piotrgrobelny/STM32WL-433MHZ-board/Documentation/Project schematic/STM32WL_board_433MHZ.pdf

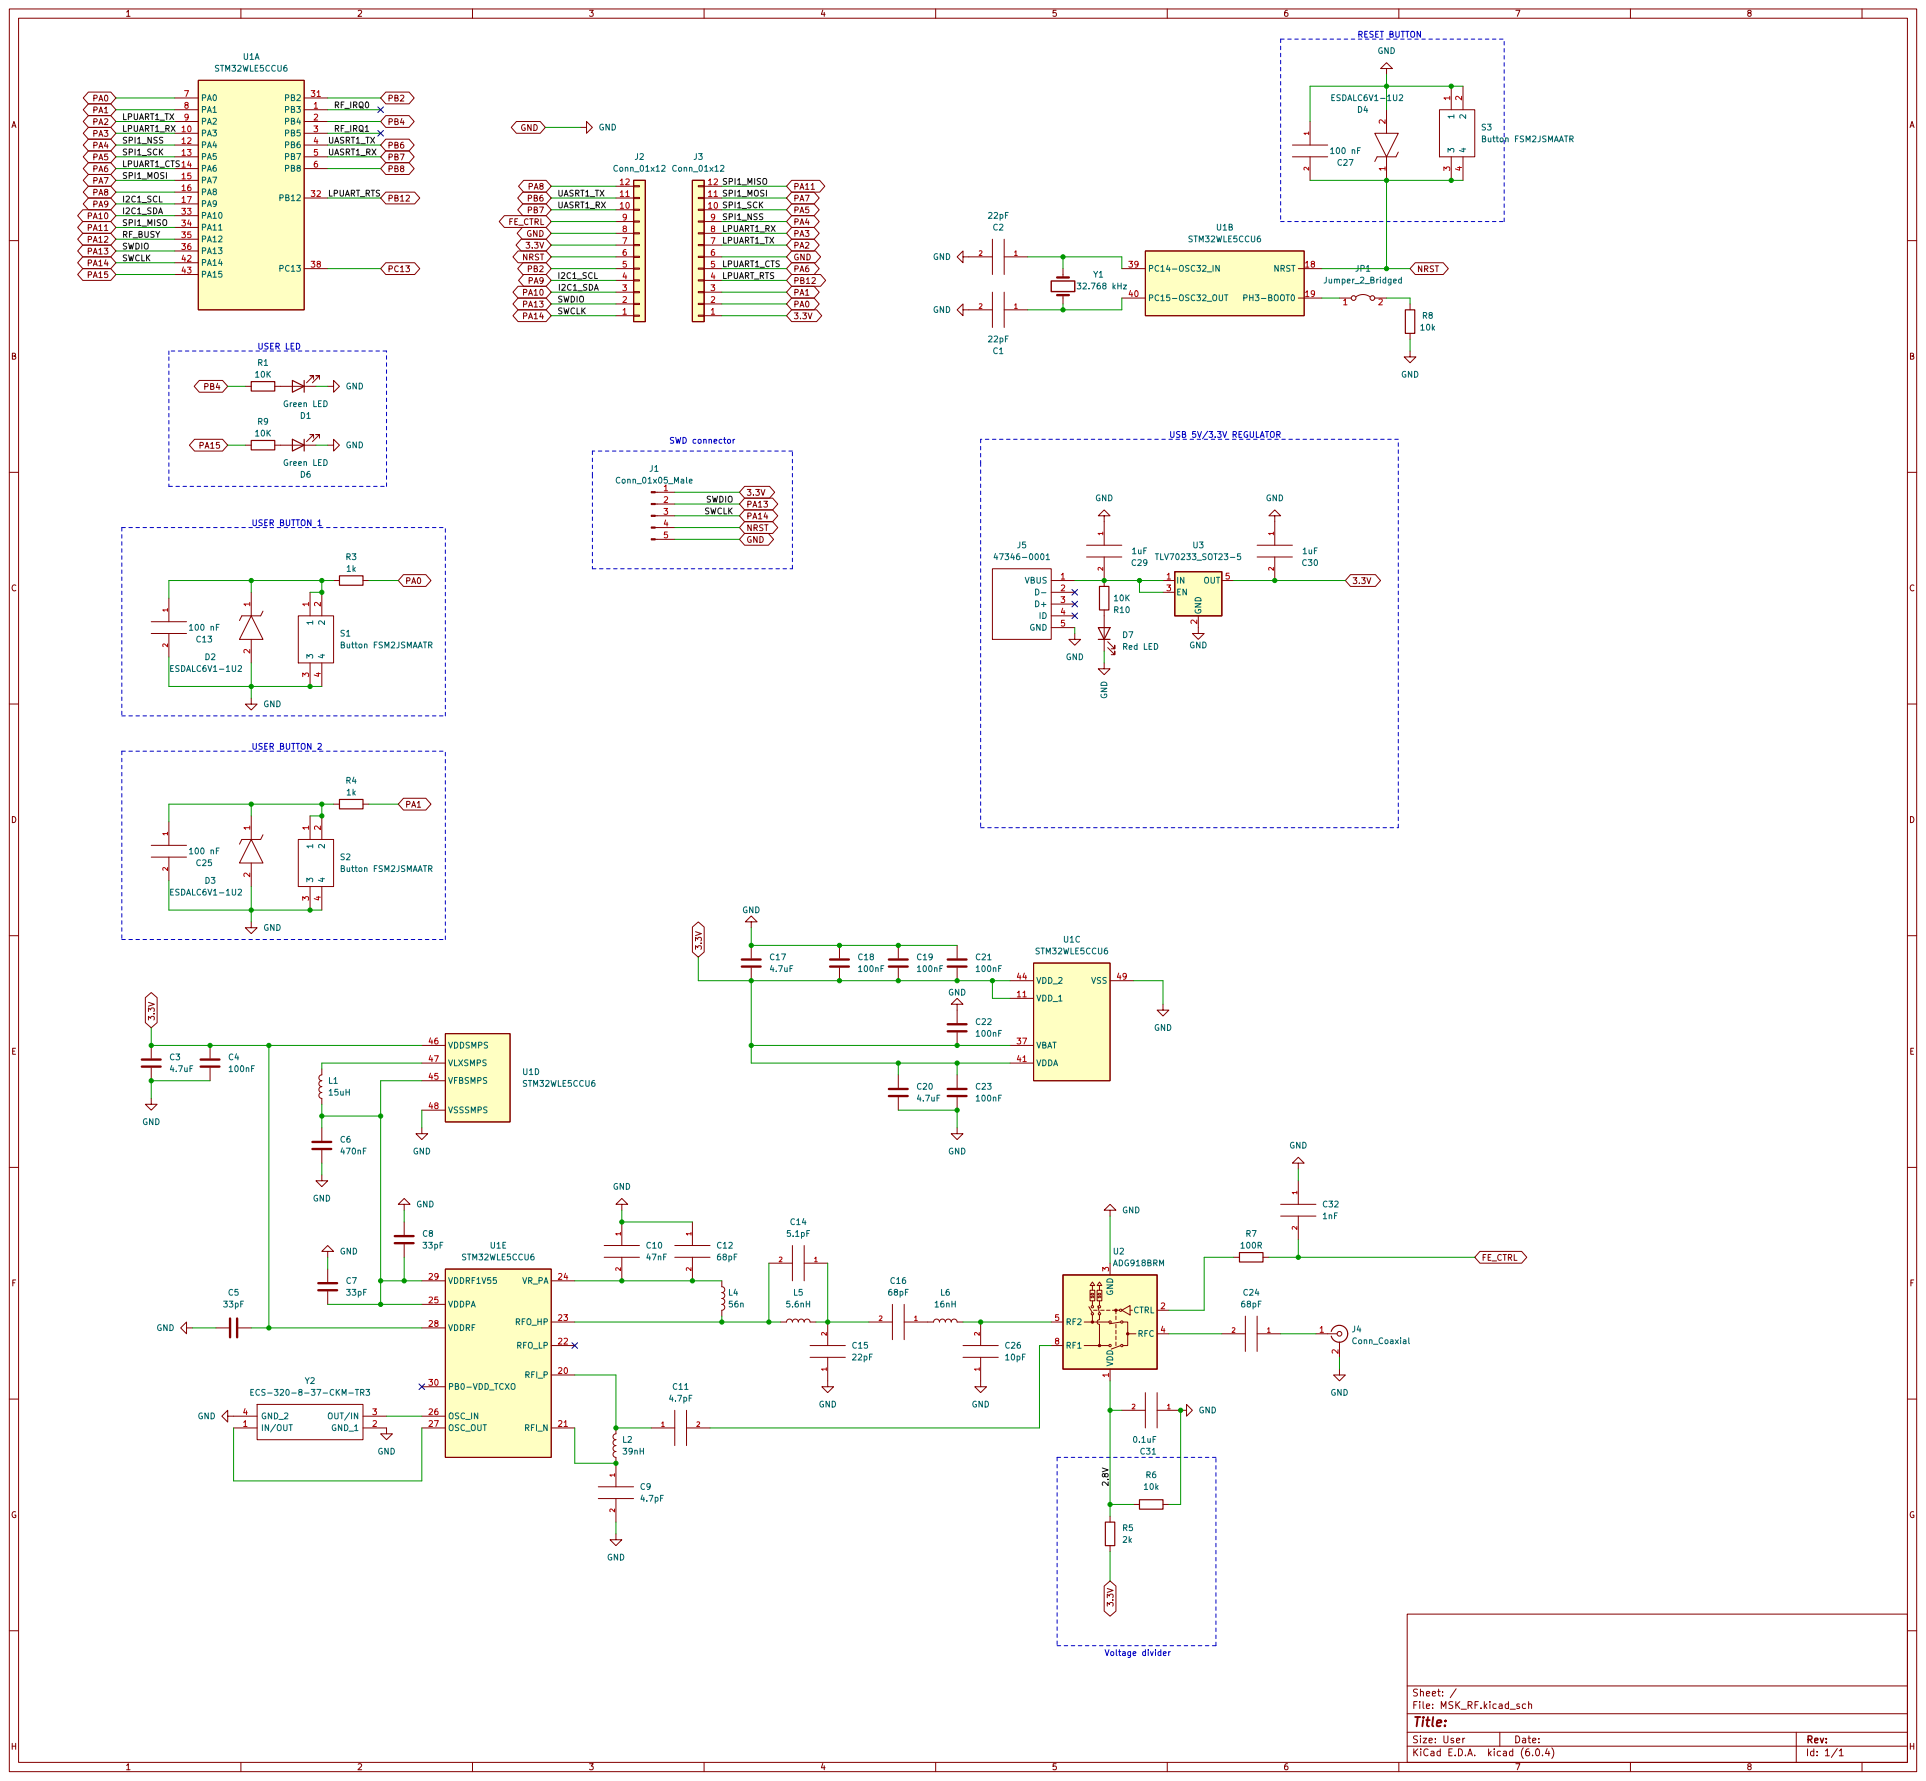
[picture p5: page 1]

SWD connector USER BUTTON 1 USER BUTTON 2
