piotrgrobelny/STM32WL-433MHZ-board/Documentation/STM32WL schematics/en.MB1389-WL55JC-lowband-E02_Schematic.pdf

Title: Project overview

Size:

Reference:
A4 | Sheet: | of

Revision:

Project: NUCLEO-WL5JC

E 02 | MB1389
2020-April-28

Low-band

Date:

Variant:

Table of contents | Legend

General comment such as function title, configuration, ...

Sheet 2: mb1367_Top | Text to be added to silkscreen.

Sheet 1: Project overview (this page)

# NUCLEO-WL5JC

MB1389

Sheet 4: STM32 microcontroller power & user buttons

Sheet 3: STM32 microcontroller I/Os | Warning text.

# OPEN PLATFORM LICENSE AGREEMENT

The Open Platform License Agreement (“Agreement”) is a binding legal contract between you ("You")

and STMicroelectronics International N.V. (“ST”), a company incorporated under the laws of the

Netherlands acting for the purpose of this Agreement through its Swiss branch 39, Chemin du

Champ des Filles, 1228 Plan-les-Ouates, Geneva, Switzerland.

By using the enclosed reference designs, schematics, PC board layouts, and documentation, in hardcopy

or CAD tool file format (collectively, the “Reference Material”), You are agreeing to be bound by

the terms and conditions of this Agreement. Do not use the Reference Material until You have read

and agreed to this Agreement terms and conditions. The use of the Reference Material automatically

implies the acceptance of the Agreement terms and conditions.

The complete Open Platform License Agreement can be found on www.st.com/opla.

U_MB1389_Top
MB1389_Top.SchDoc

Sheet 7: ST-LINK/V3E-SWD Module

Sheet 6: Arduino & Morpho extension connectors

Sheet 8: ST-LINK/V3E-SWD Power Module

Sheet 5: STM32 microcontroller RF

Notes to generate the
board layout.

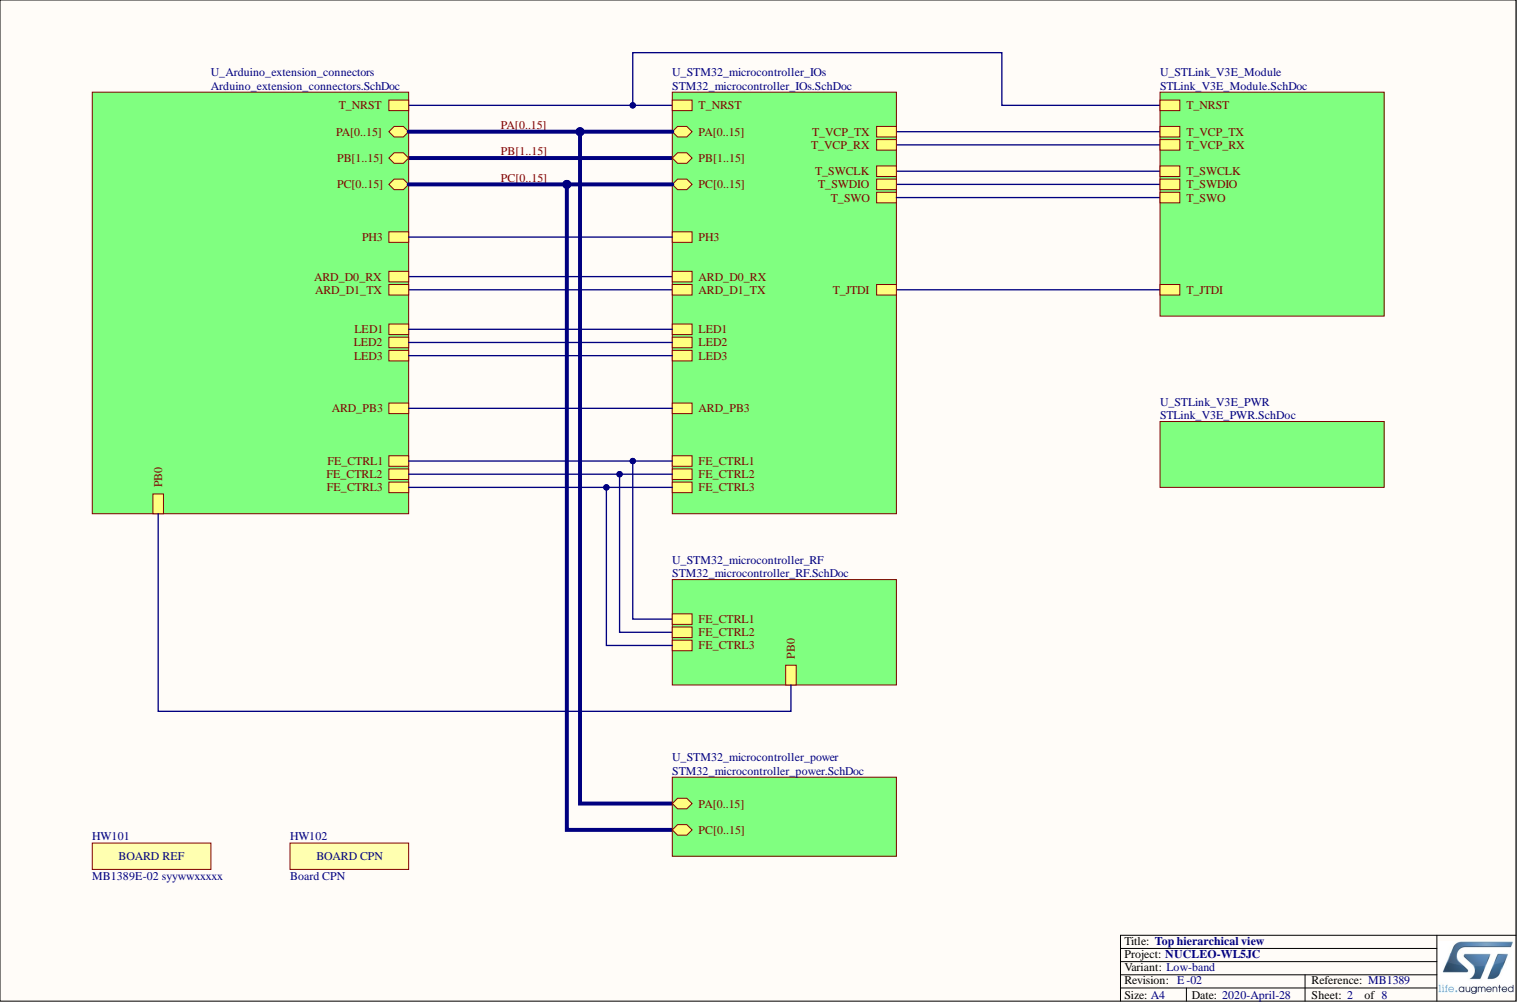
[picture p6: page 2]

Title: Top hierarchical view

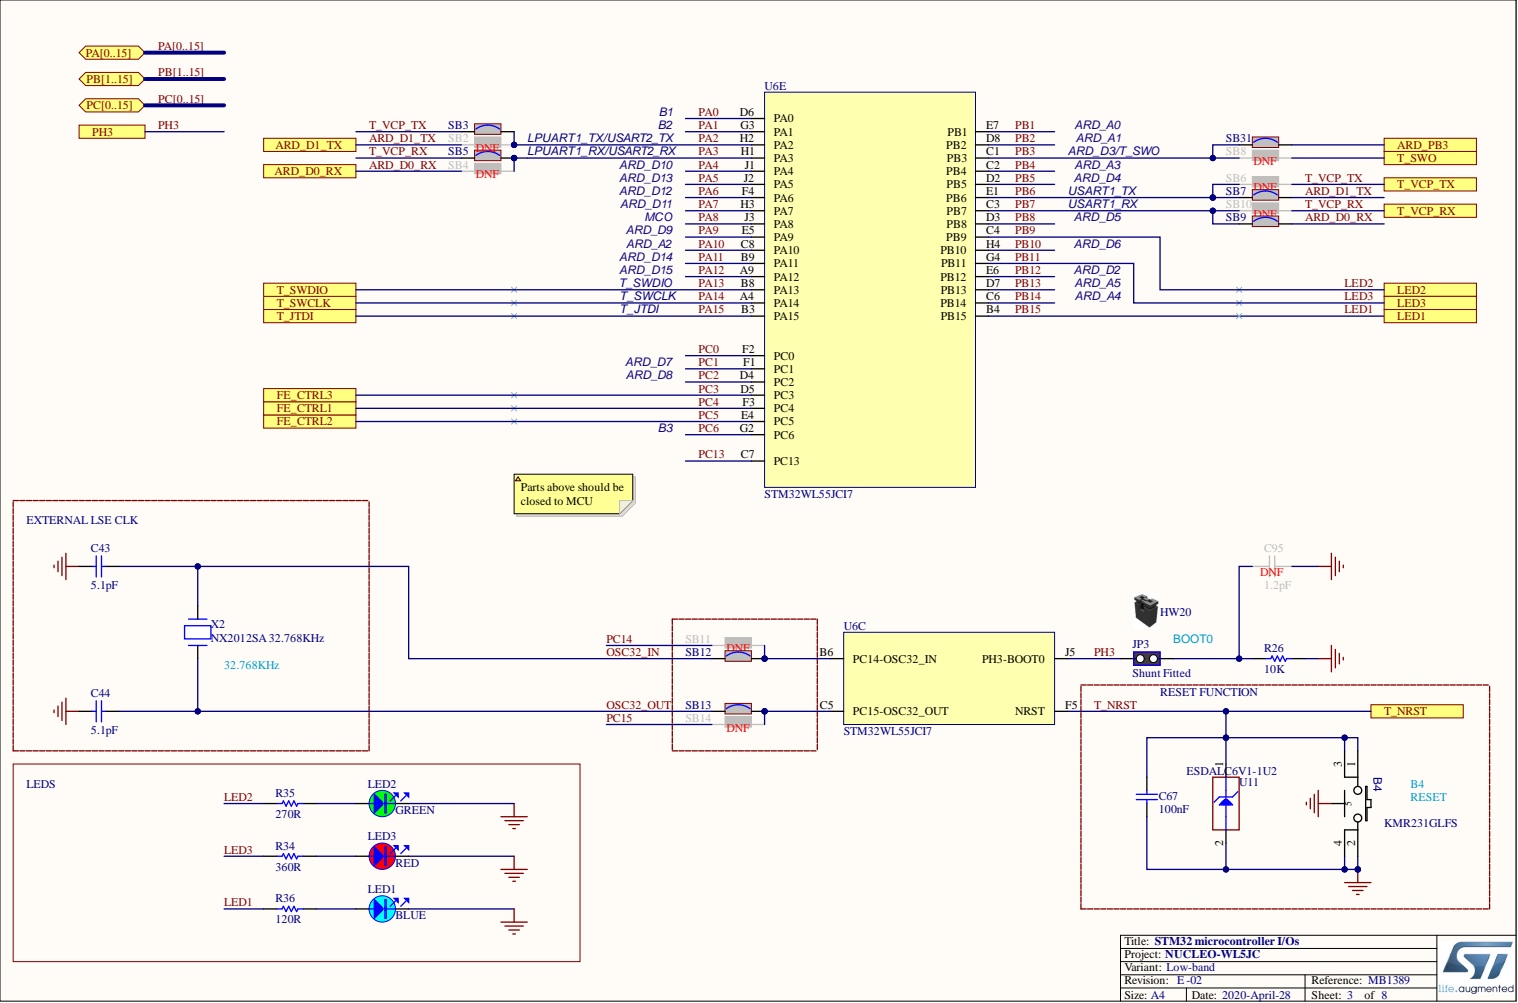
[picture p7: page 3]

T_SWC L K PA 1 4 | | PB1 4 AR D_A 4 L E D 3
T_J TD I PA 1 5 | PB1 5 L E D 1

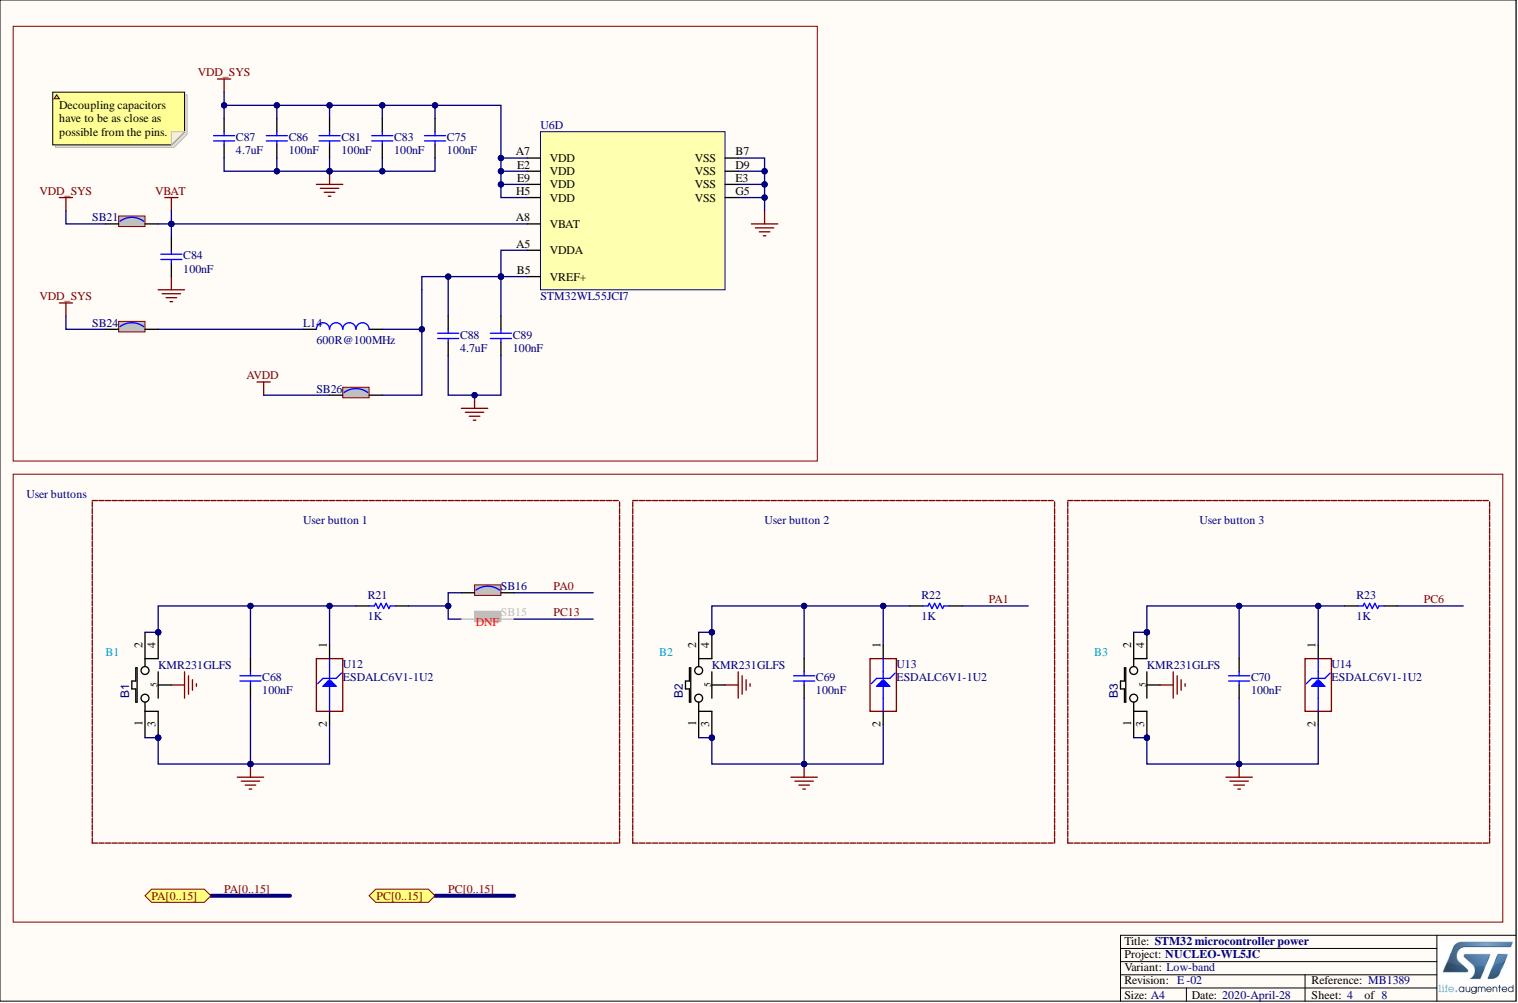
[picture p8: page 4]

Decoupling capacitors
have to be as close as
possible from the pins.

VDDA A5

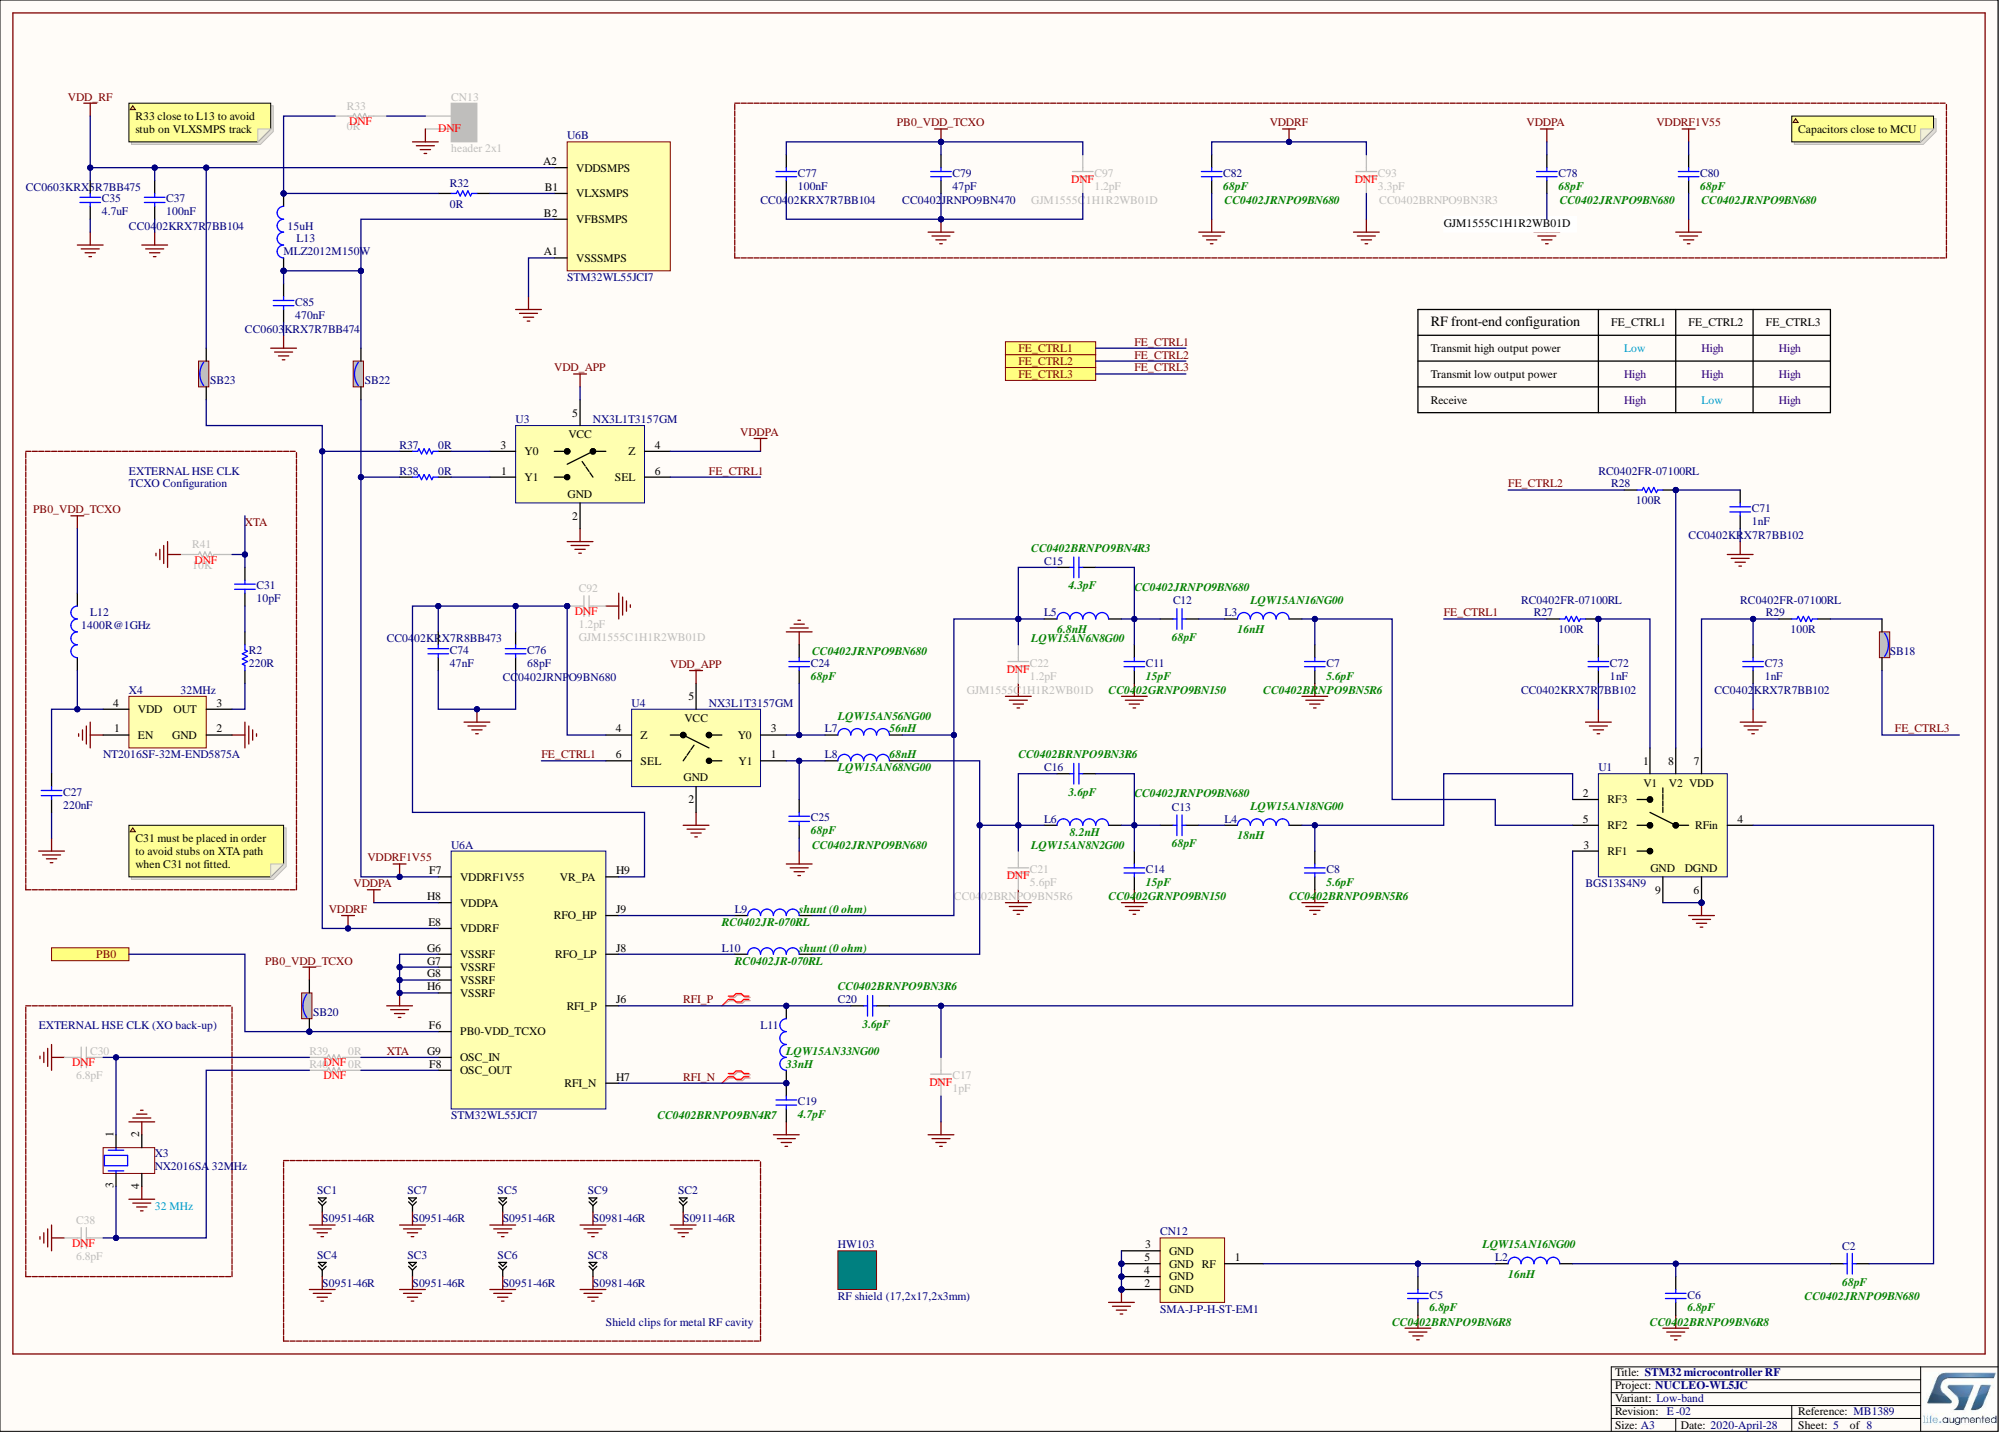
[picture p9: page 5]

R33 close to L13 to avoid
stub on VLXSMPS track

Capacitors close to MCU

RF front-end configuration | FE_CTRL1 | FE_CTRL2 | FE_CTRL3

Transmit high output power | Low | High | High

Transmit low output power

C31 must be placed in order
to avoid stubs on XTA path
when C31 not fitted.

EXTERNAL HSE CLK (XO back-up)

Shield clips for metal RF cavity

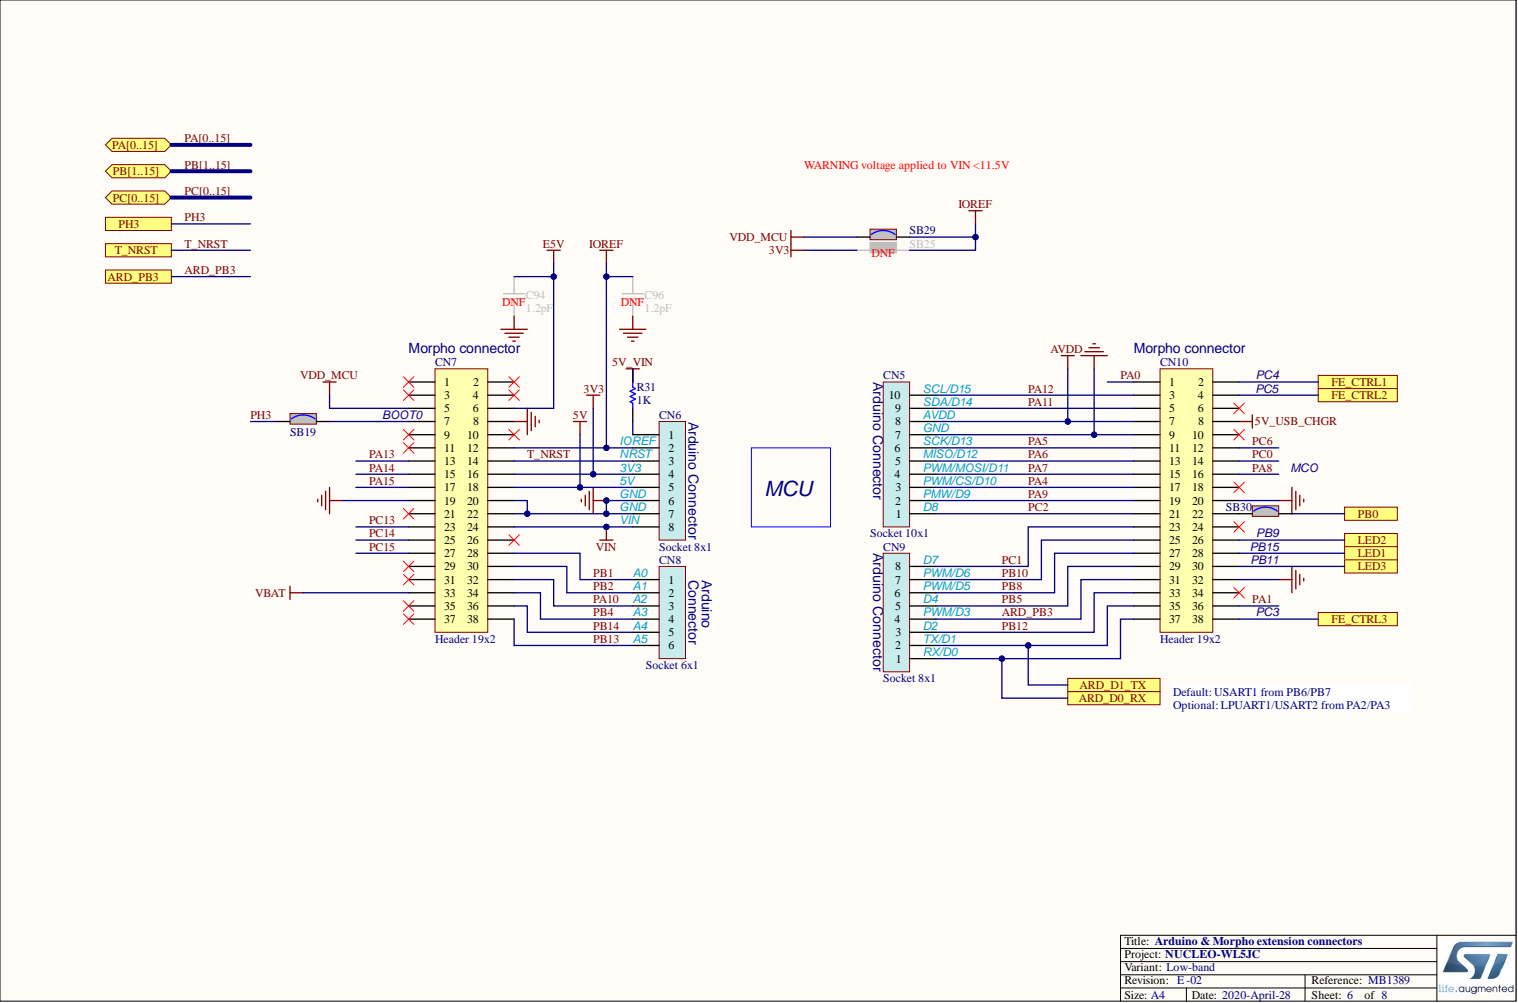
[picture p10: page 6]

WARNING voltage applied to VIN <11.5V

Arduino Connector

Title: Arduino & Morpho extension connectors

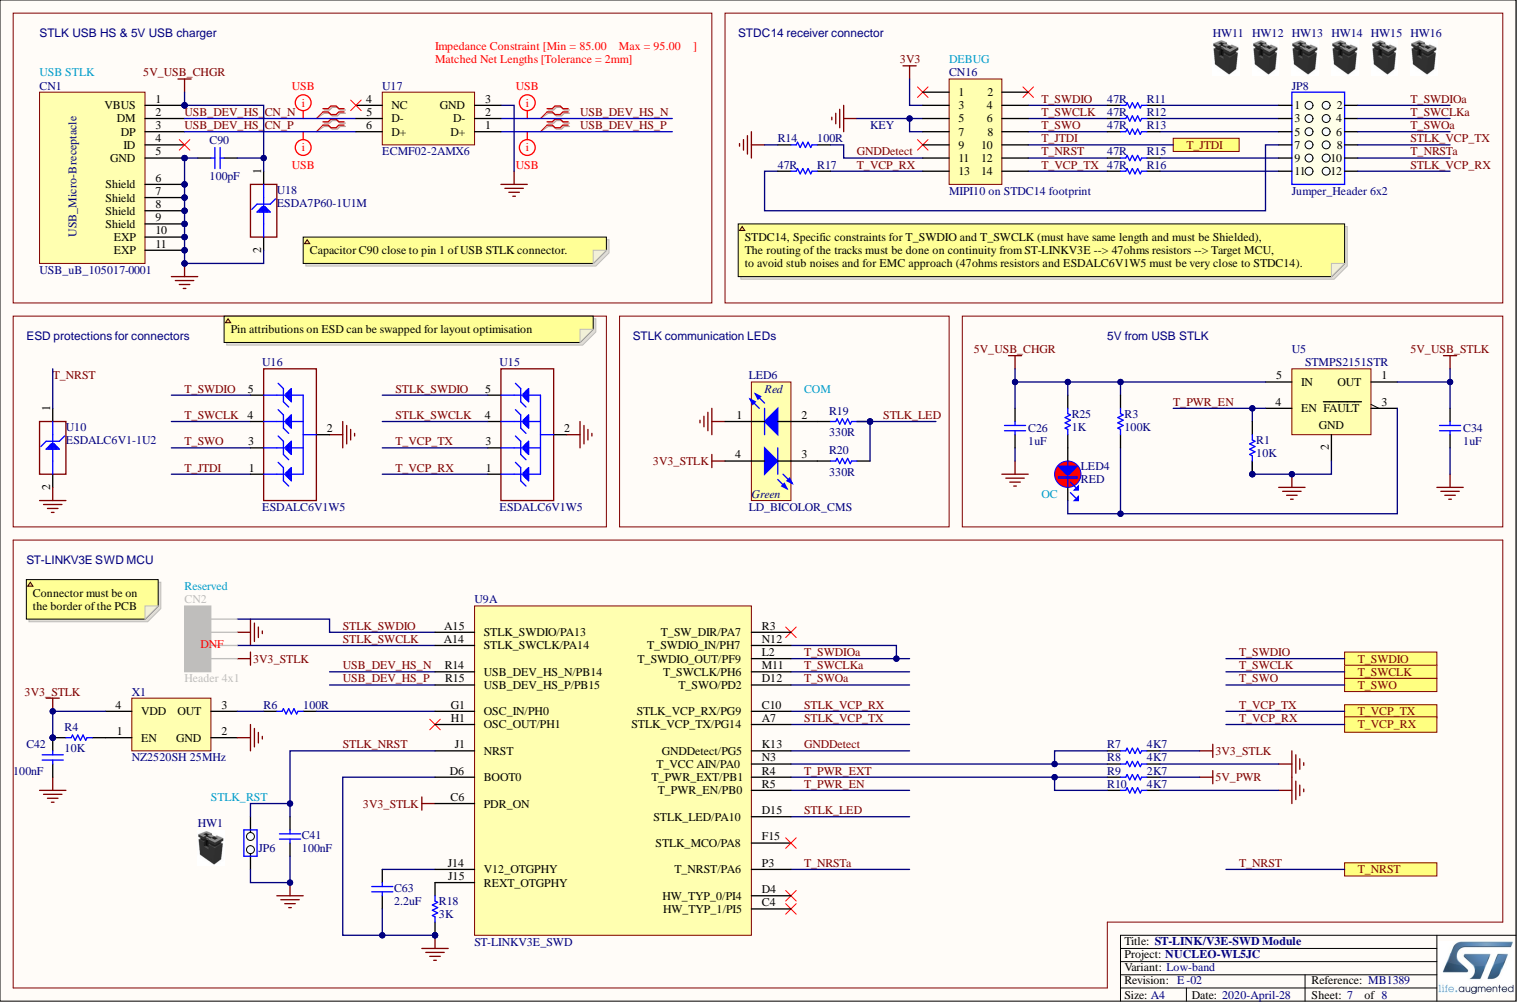
[picture p11: page 7]

Impedance Constraint [Min = 85.00 Max = 95.00 ]
Matched Net Lengths [Tolerance = 2mm]

STDC14, Specific constraints for T_SWDIO and T_SWCLK (must have same length and must be Shielded),
The routing of the tracks must be done on continuity from ST-LINKV3E --> 47ohms resistors --> Target MCU,
to avoid stub noises and for EMC approach (47ohms resistors and ESDALC6V1W5 must be very close to STDC14).

Capacitor C90 close to pin 1 of USB STLK connector.

Pin attributions on ESD can be swapped for layout optimisation

Connector must be on
the border of the PCB

STLK_SWCLK | STLK_SWCLK/PA14 A14
USB_DEV_HS_P | USB_DEV_HS_N/PB14 R14 USB_DEV_HS_P/PB15 R15 OSC_IN/PH0 G1 | | T_SWDIOa

Title: ST-LINK/V3E-SWD Module

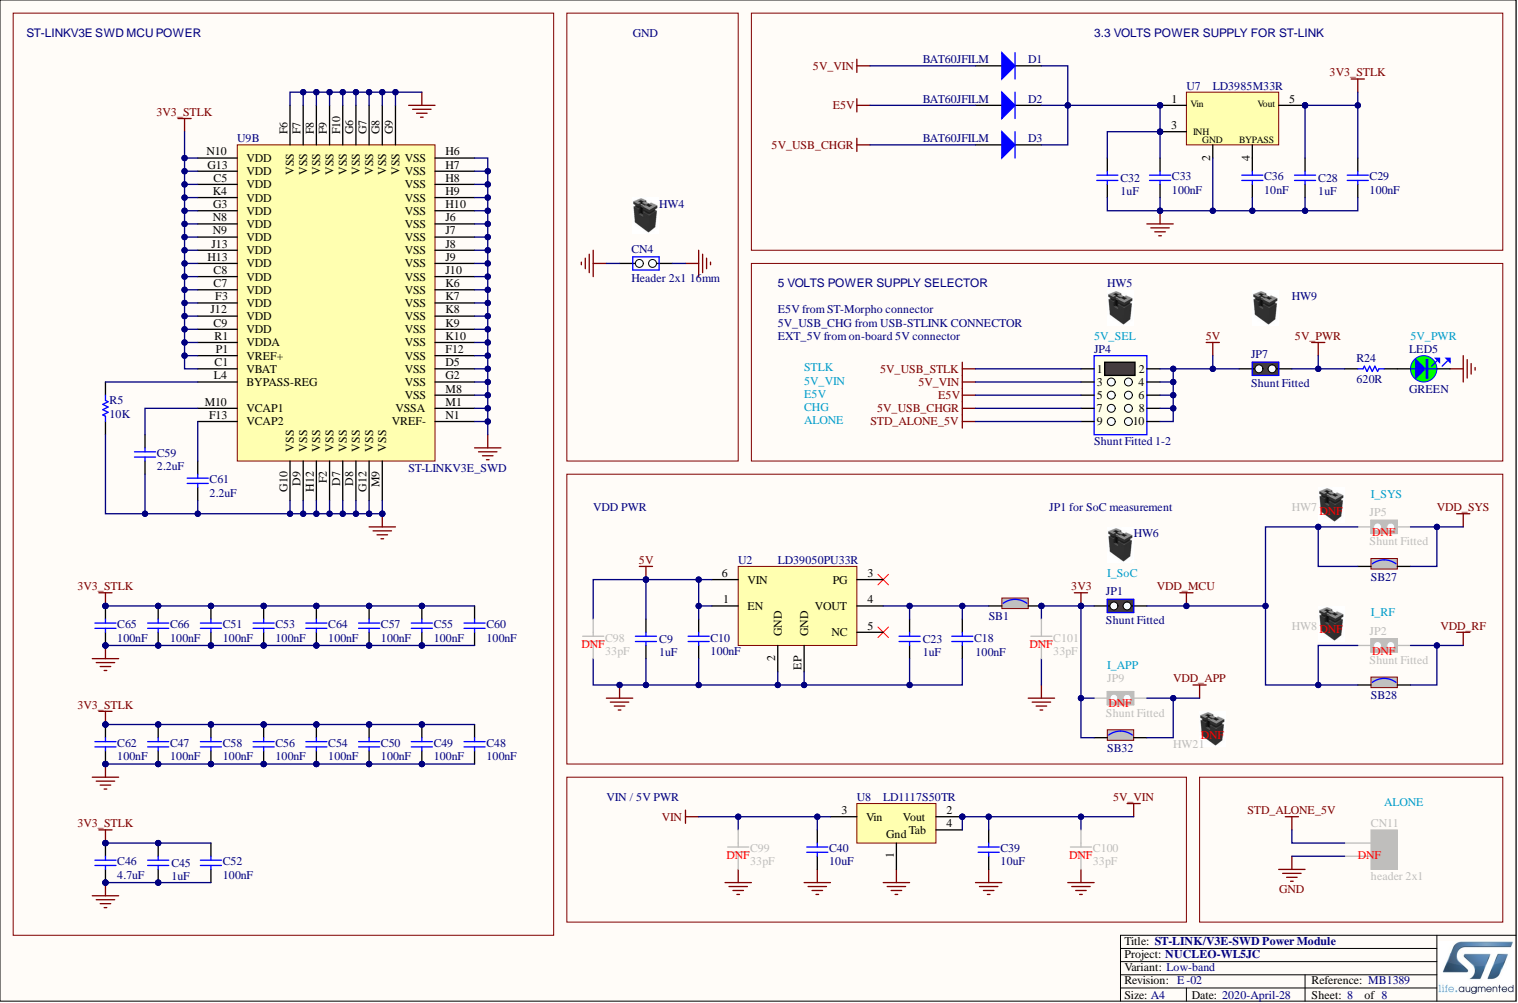
[picture p12: page 8]

ST-LINKV3E SWD MCU POWER

3.3 VOLTS POWER SUPPLY FOR ST-LINK

VSS M9 VSS G12 VSS D8 VSS D7 VSS F2 VSS H12 VSS D9 VSS F6

5 VOLTS POWER SUPPLY SELECTOR

E5V from ST-Morpho connector
5V_USB_CHG from USB-STLINK CONNECTOR
EXT_5V from on-board 5V connector

Title: ST-LINK/V3E-SWD Power Module
