piotrgrobelny/STM32WL-433MHZ-board/Documentation/STM32WL schematics/STM32WL_UFQFPN48_REF_BOARD_Low_Power_Low_Band_433MHz.pdf

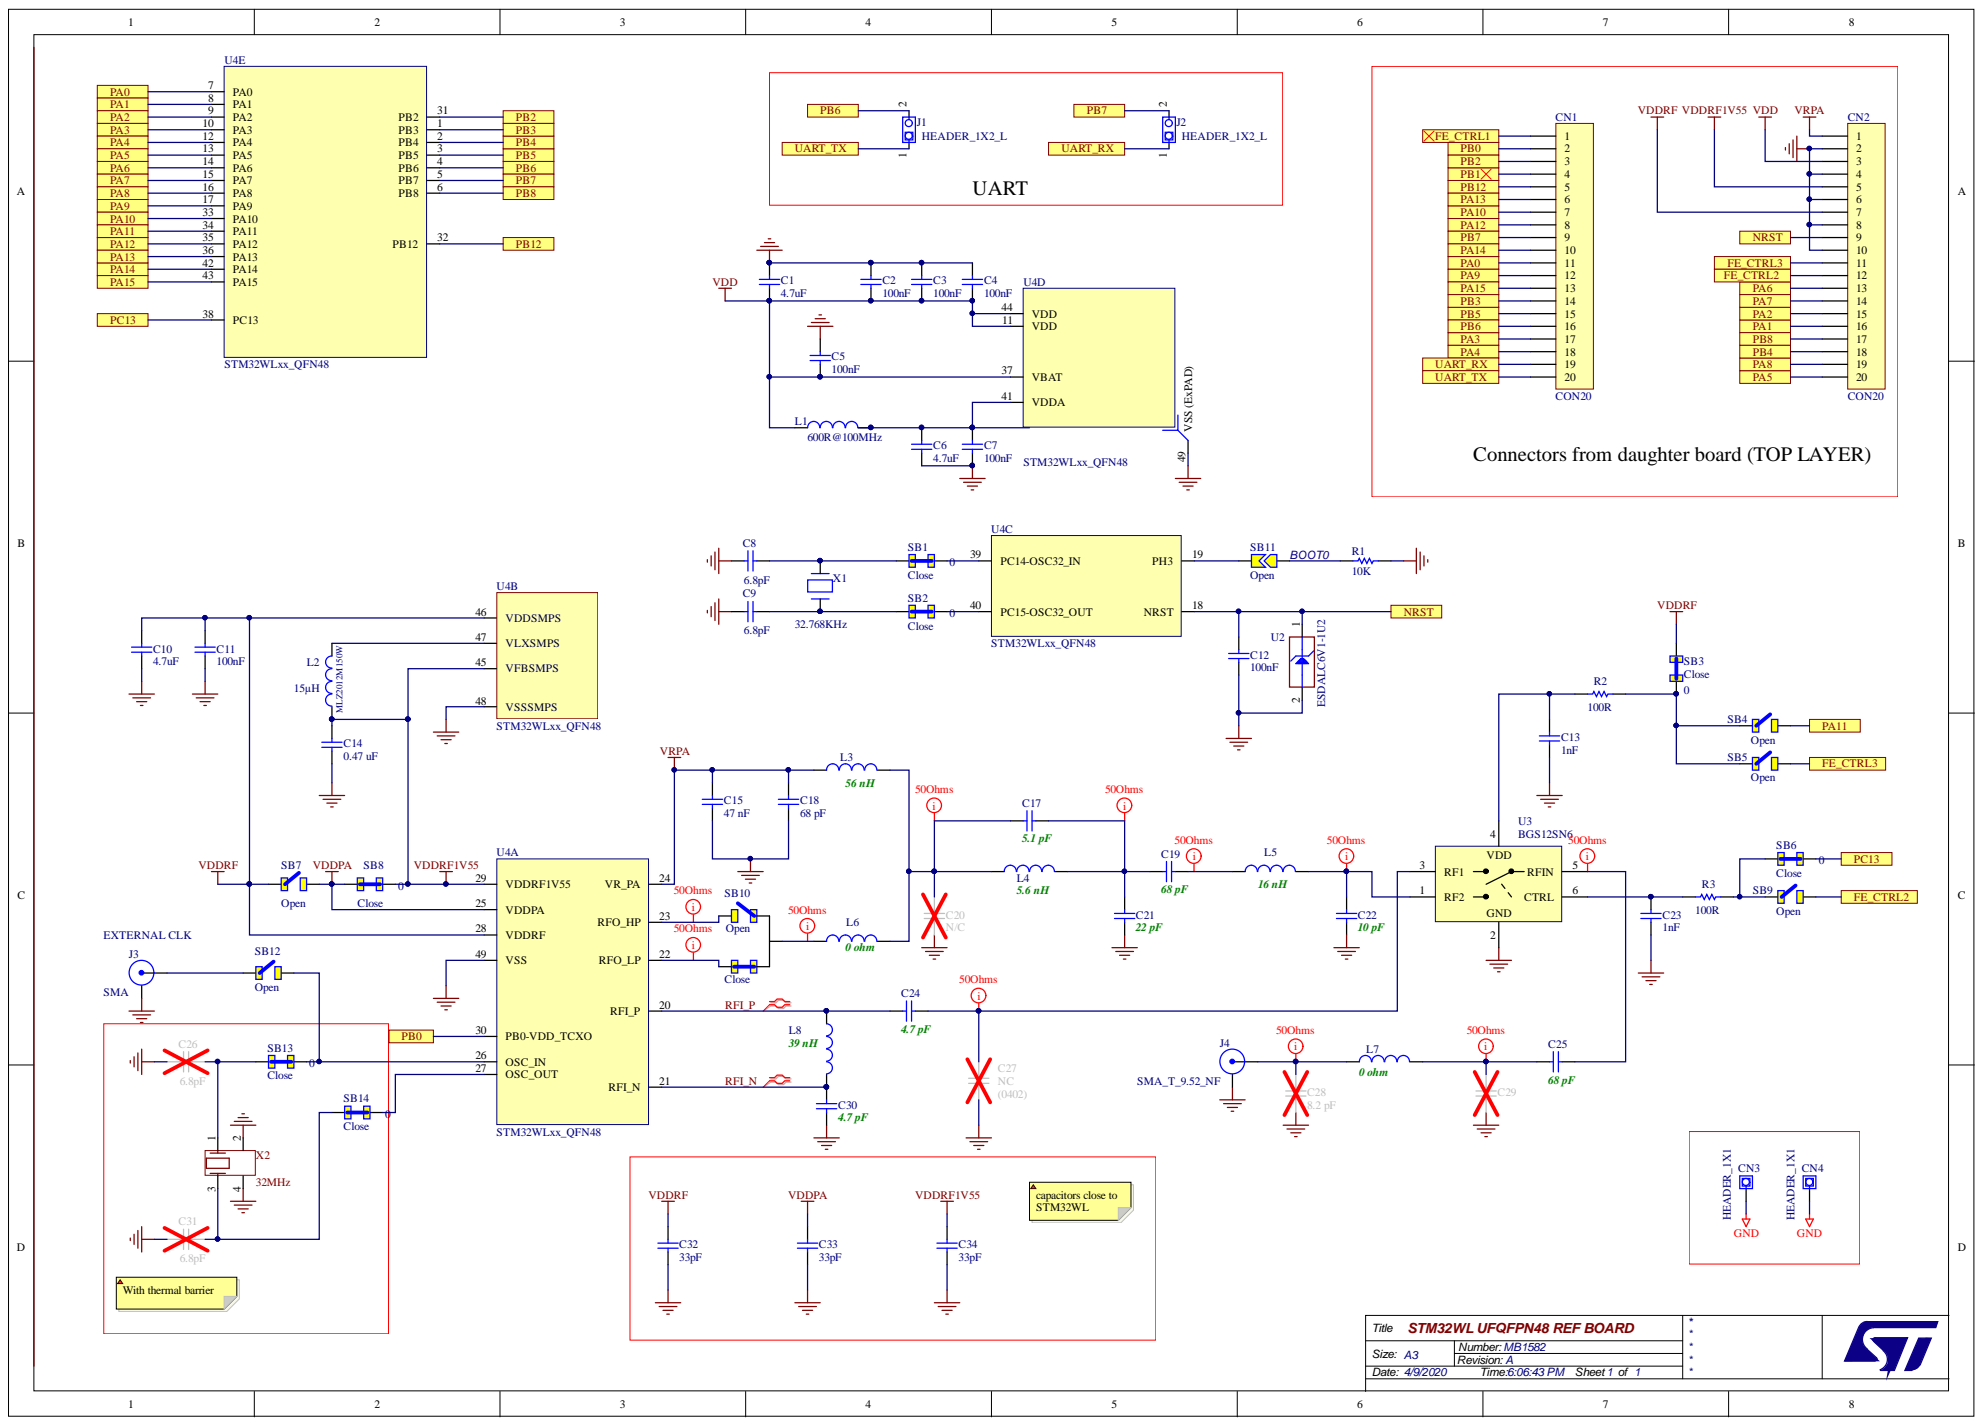
[picture p13: page 1]

Connectors from daughter board (TOP LAYER)

PB0 | OSC_IN 26

Size: A3 | Number: MB1582
