piotrgrobelny/STM32WL-433MHZ-board/KiCad/MSK_RF.kicad_pcb

## KiCad design KiCad/MSK_RF.kicad_pcb (2022-05-19)

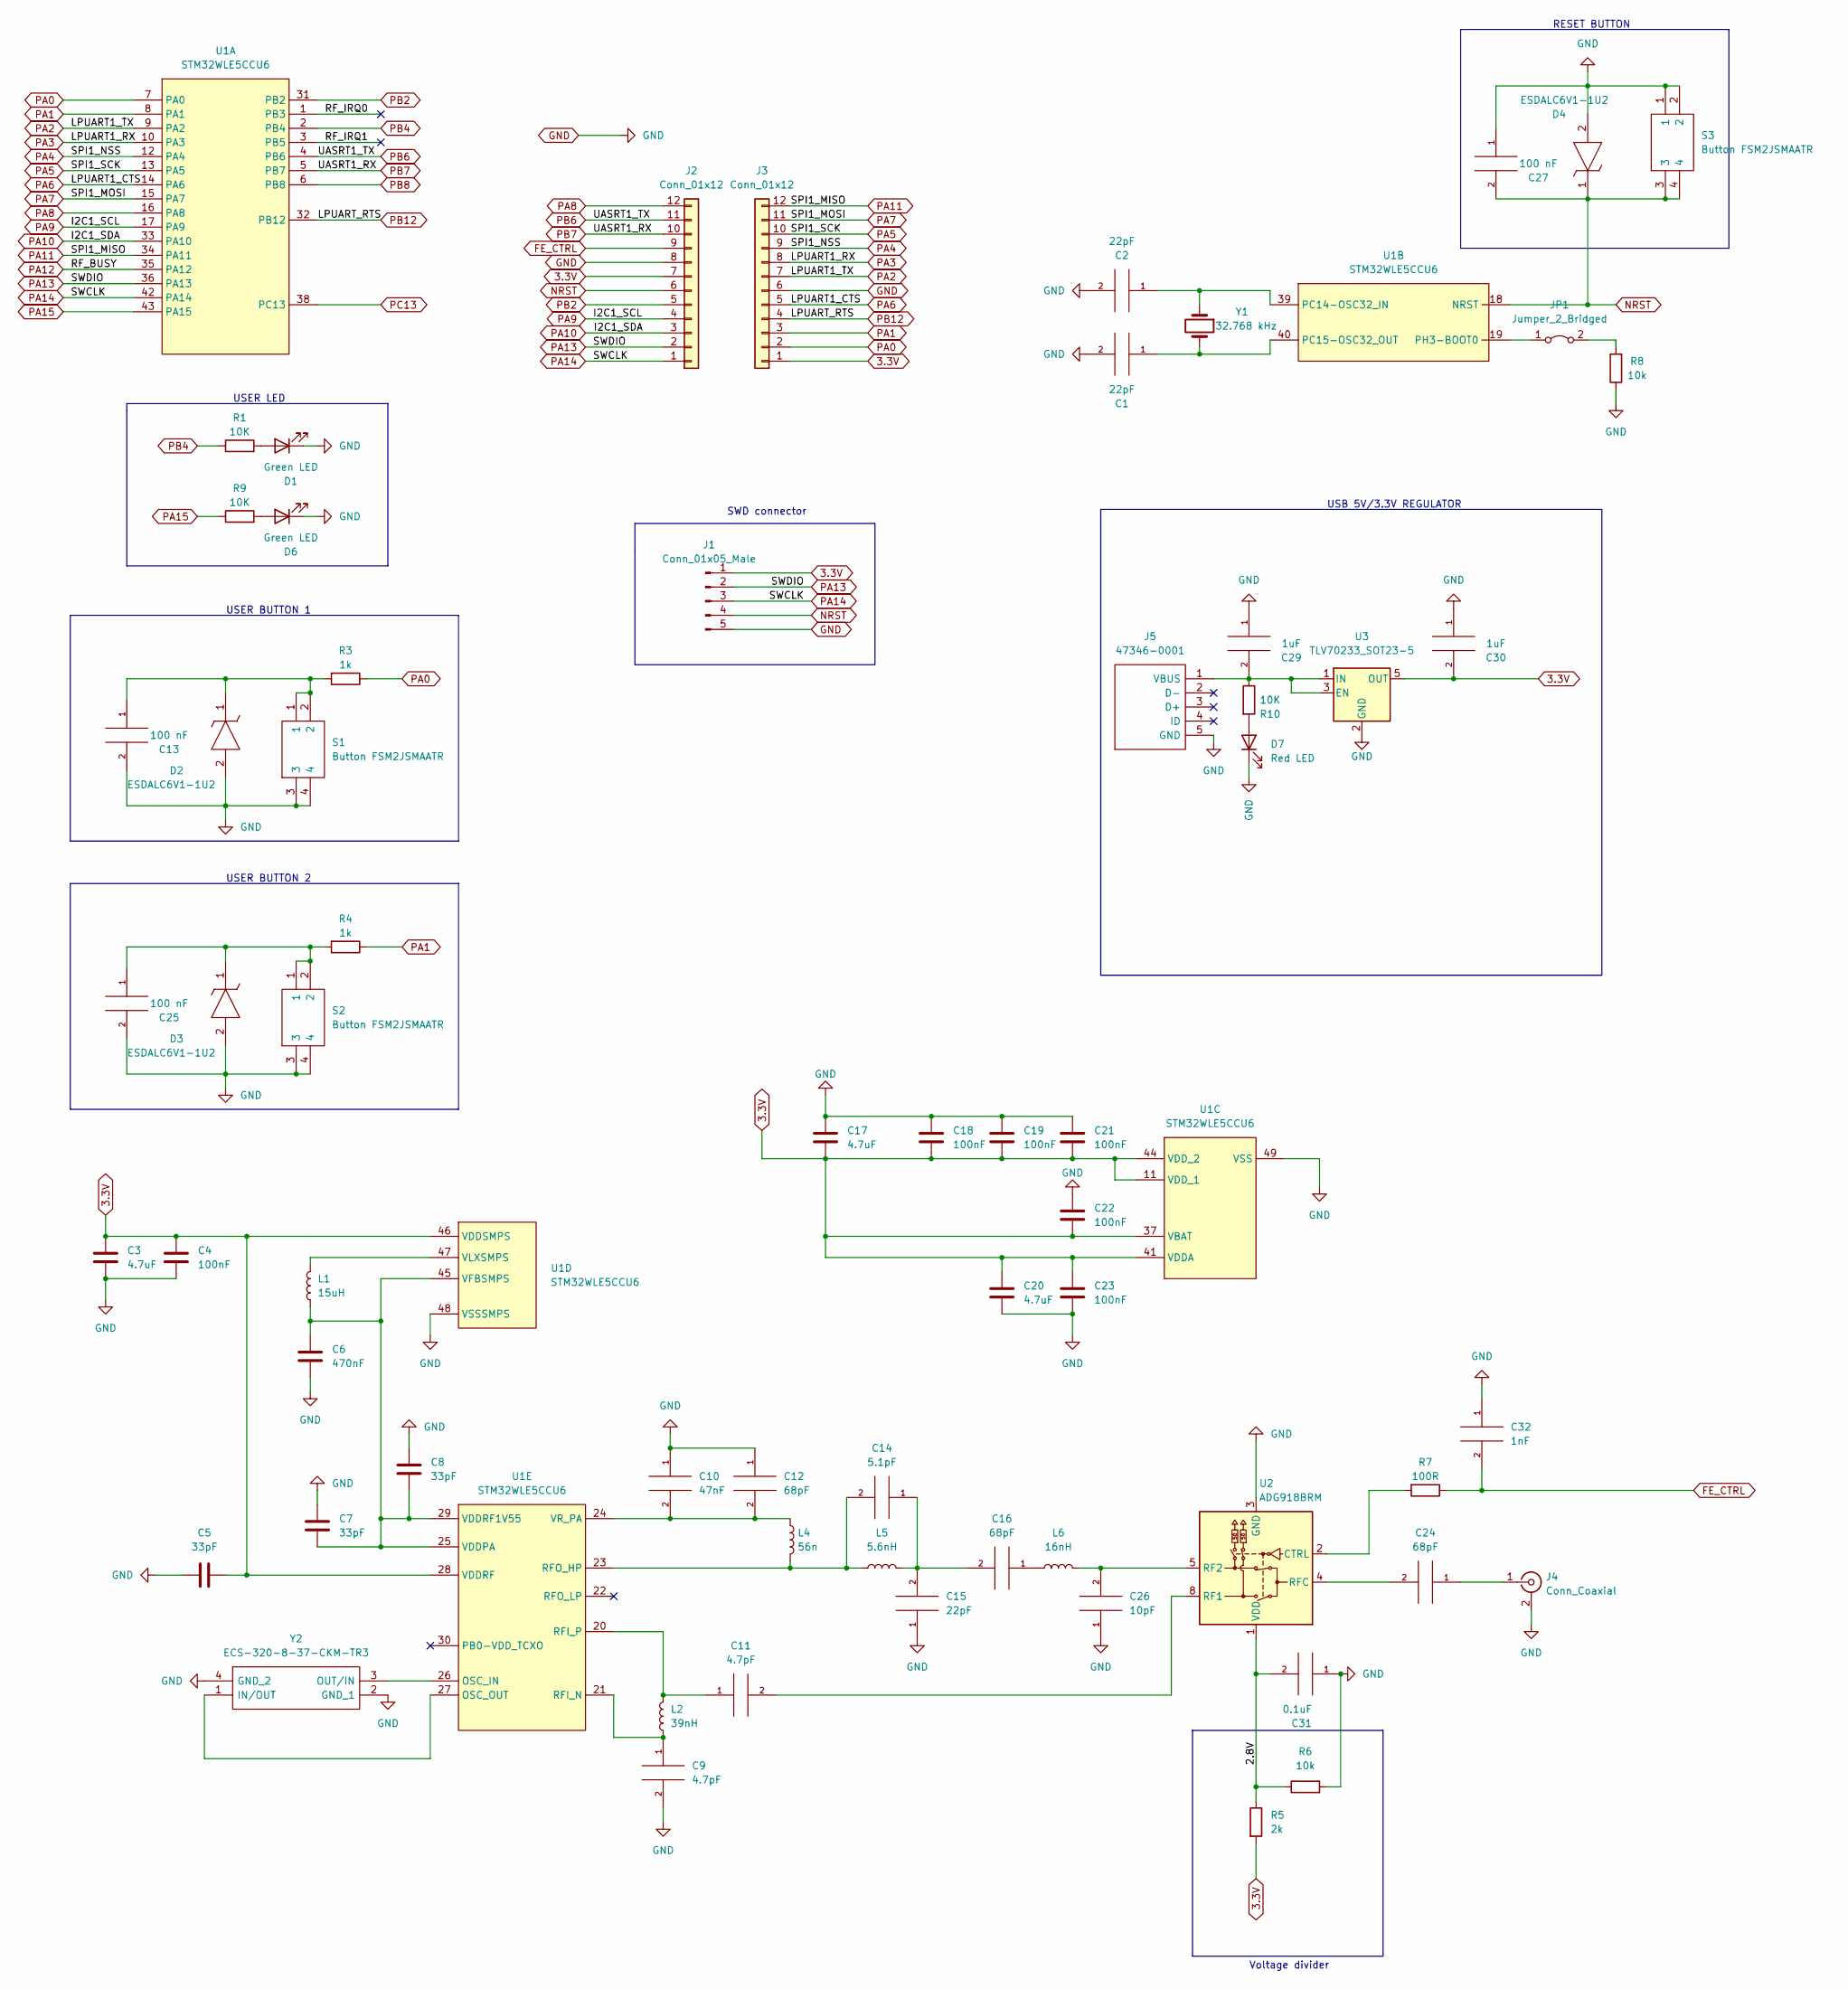
[picture p14: schematic MSK_RF.kicad_sch]

Parts:
C1, C2: 22pF; CP_Elec_3x5.3
C3, C17, C20: 4.7uF; C_0603_1608Metric_Pad1.08x0.95mm_HandSolder
C4, C18, C19, C21, C22, C23: 100nF; C_0603_1608Metric_Pad1.08x0.95mm_HandSolder
C5, C7, C8: 33pF; C_0603_1608Metric_Pad1.08x0.95mm_HandSolder
C6: 470nF; C_0603_1608Metric_Pad1.08x0.95mm_HandSolder
C9, C11: 4.7pF; C_0603_1608Metric_Pad1.08x0.95mm_HandSolder
C10: 47nF; C_0603_1608Metric_Pad1.08x0.95mm_HandSolder
C12, C16, C24: 68pF; C_0603_1608Metric_Pad1.08x0.95mm_HandSolder
C13, C25, C27: 100 nF; C_0603_1608Metric_Pad1.08x0.95mm_HandSolder
C14: 5.1pF; C_0603_1608Metric_Pad1.08x0.95mm_HandSolder
C15: 22pF; C_0603_1608Metric_Pad1.08x0.95mm_HandSolder
C26: 10pF; C_0603_1608Metric_Pad1.08x0.95mm_HandSolder
C29, C30: 1uF; C_0603_1608Metric_Pad1.08x0.95mm_HandSolder
C31: 0.1uF; C_0603_1608Metric_Pad1.08x0.95mm_HandSolder
C32: 1nF; C_0603_1608Metric_Pad1.08x0.95mm_HandSolder
D1, D6: Green LED; LED_0603_1608Metric_Pad1.05x0.95mm_HandSolder
D2, D3, D4: ESDALC6V1-1U2; ESDALC6V11U2; Mouser Part Number 511-ESDALC6V1-1U2
D7: Red LED; LED_0603_1608Metric_Pad1.05x0.95mm_HandSolder
J1: Conn_01x05_Male; PinHeader_1x05_P2.54mm_Vertical
J2, J3: Conn_01x12; PinSocket_1x12_P2.54mm_Vertical
J4: Conn_Coaxial; SMA_Molex_73251-1153_EdgeMount_Horizontal
J5: 47346-0001; Mouser Part Number 538-47346-0001
JP1: Jumper_2_Bridged; PinHeader_1x02_P2.54mm_Vertical
L1: 15uH; L_0603_1608Metric_Pad1.05x0.95mm_HandSolder
L2: 39nH; L_0603_1608Metric_Pad1.05x0.95mm_HandSolder
L4: 56n; L_0603_1608Metric_Pad1.05x0.95mm_HandSolder
L5: 5.6nH; L_0603_1608Metric_Pad1.05x0.95mm_HandSolder
L6: 16nH; L_0603_1608Metric_Pad1.05x0.95mm_HandSolder
R1, R9, R10: 10K; R_0603_1608Metric_Pad0.98x0.95mm_HandSolder
R3, R4: 1k; R_0603_1608Metric_Pad0.98x0.95mm_HandSolder
R5: 2k; R_0603_1608Metric_Pad0.98x0.95mm_HandSolder
R6, R8: 10k; R_0603_1608Metric_Pad0.98x0.95mm_HandSolder
R7: 100R; R_0603_1608Metric_Pad0.98x0.95mm_HandSolder
S1, S2, S3: Button FSM2JSMAATR; FSM2J_1; Mouser Part Number 506-FSM2JSMAATR
U1: STM32WLE5CCU6; QFN50P700X700X60-49N-D
U2: ADG918BRM; MSOP-8_3x3mm_P0.65mm
U3: TLV70233_SOT23-5; SOT-23-5
Y1: 32.768 kHz; ECX-31B
Y2: ECS-320-8-37-CKM-TR3; ECS320837CKMTR3; Mouser Part Number 520-ECS-320837CKMTR3

Connections:
3.3V: C3.1, C4.1, C5.1, C17.2, C18.2, C19.2, C20.1, C21.2, C22.2, C23.1, C30.2, J1.1, J2.7, J3.1, R5.2, U1.11 (VDD_1), U1.28 (VDDRF), U1.37 (VBAT), U1.41 (VDDA), U1.44 (VDD_2), U1.46 (VDDSMPS), U3.5 (OUT)
/2.8V: C31.2, R5.1, R6.1, U2.1 (VDD)
/RF_IRQ0: U1.1 (PB3)
/RF_IRQ1: U1.3 (PB5)
FE_CTRL: C32.2, J2.9, R7.1
GND: C1.2, C2.2, C3.2, C4.2, C5.2, C6.2, C7.1, C8.1, C9.2, C10.1, C12.1, C13.2, C15.1, C17.1, C18.1, C19.1, C20.2, C21.1, C22.1, C23.2, C25.2, C26.1, C27.1, C29.1, C30.1, C31.1, C32.1, D1.1 (K), D2.2, D3.2, D4.2, D6.1 (K), D7.1 (K), J1.5, J2.8, J3.6, J4.2 (Ext), J5.5 (GND), R6.2, R8.1, S1.3, S1.4, S2.3, S2.4, S3.1, S3.2, U1.48 (VSSSMPS), U1.49 (VSS), U2.3 (GND), U2.6 (GND), U2.7 (GND), U3.2 (GND), Y2.2 (GND_1), Y2.4 (GND_2)
NRST: C27.2, D4.1, J1.4, J2.6, S3.3, S3.4, U1.18 (NRST)
unnamed: C1.1, U1.40 (PC15-OSC32_OUT), Y1.2
unnamed: C2.1, U1.39 (PC14-OSC32_IN), Y1.1
unnamed: C6.1, C7.2, C8.2, L1.1, U1.25 (VDDPA), U1.29 (VDDRF1V55), U1.45 (VFBSMPS)
unnamed: C9.1, L2.1, U1.21 (RFI_N)
unnamed: C10.2, C12.2, L4.1, U1.24 (VR_PA)
unnamed: C11.1, L2.2, U1.20 (RFI_P)
unnamed: C11.2, U2.8 (RF1)
unnamed: C13.1, D2.1, R3.2, S1.1, S1.2
unnamed: C14.1, C15.2, C16.2, L5.2
unnamed: C14.2, L4.2, L5.1, U1.23 (RFO_HP)
unnamed: C16.1, L6.1
unnamed: C24.1, J4.1 (In)
unnamed: C24.2, U2.4 (RFC)
unnamed: C25.1, D3.1, R4.2, S2.1, S2.2
unnamed: C26.2, L6.2, U2.5 (RF2)
unnamed: C29.2, J5.1 (VBUS), R10.1, U3.1 (IN), U3.3 (EN)
unnamed: D1.2 (A), R1.2
unnamed: D6.2 (A), R9.2
unnamed: D7.2 (A), R10.2
unnamed: JP1.1 (A), U1.19 (PH3-BOOT0)
unnamed: JP1.2 (B), R8.2
unnamed: L1.2, U1.47 (VLXSMPS)
unnamed: R7.2, U2.2 (CTRL)
unnamed: U1.26 (OSC_IN), Y2.3 (OUT/IN)
unnamed: U1.27 (OSC_OUT), Y2.1 (IN/OUT)
PA0: J3.2, R3.1, U1.7 (PA0)
PA1: J3.3, R4.1, U1.8 (PA1)
PA2: J3.7, U1.9 (PA2)
PA3: J3.8, U1.10 (PA3)
PA4: J3.9, U1.12 (PA4)
PA5: J3.10, U1.13 (PA5)
PA6: J3.5, U1.14 (PA6)
PA7: J3.11, U1.15 (PA7)
PA8: J2.12, U1.16 (PA8)
PA9: J2.4, U1.17 (PA9)
PA10: J2.3, U1.33 (PA10)
PA11: J3.12, U1.34 (PA11)
PA12: U1.35 (PA12)
PA13: J1.2, J2.2, U1.36 (PA13)
PA14: J1.3, J2.1, U1.42 (PA14)
PA15: R9.1, U1.43 (PA15)
PB2: J2.5, U1.31 (PB2)
PB4: R1.1, U1.2 (PB4)
PB6: J2.11, U1.4 (PB6)
PB7: J2.10, U1.5 (PB7)
PB8: U1.6 (PB8)
PB12: J3.4, U1.32 (PB12)
PC13: U1.38 (PC13)

Notes on the sheet:
SWD connector
USER BUTTON 2
RESET BUTTON
USER LED
USB 5V/3.3V REGULATOR
USER BUTTON 1
Voltage divider

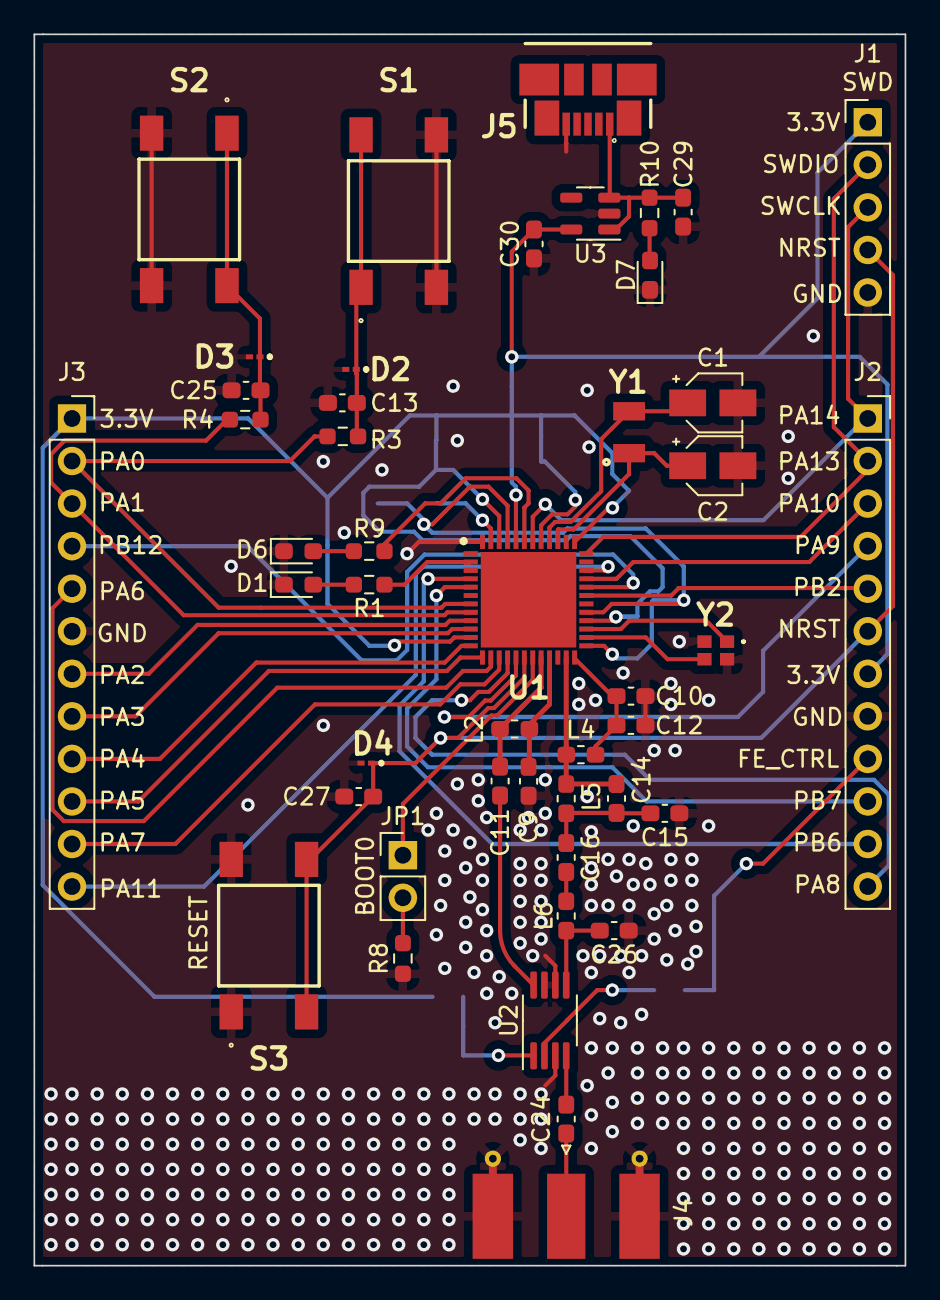
[picture p15: board MSK_RF.kicad_pcb from above]

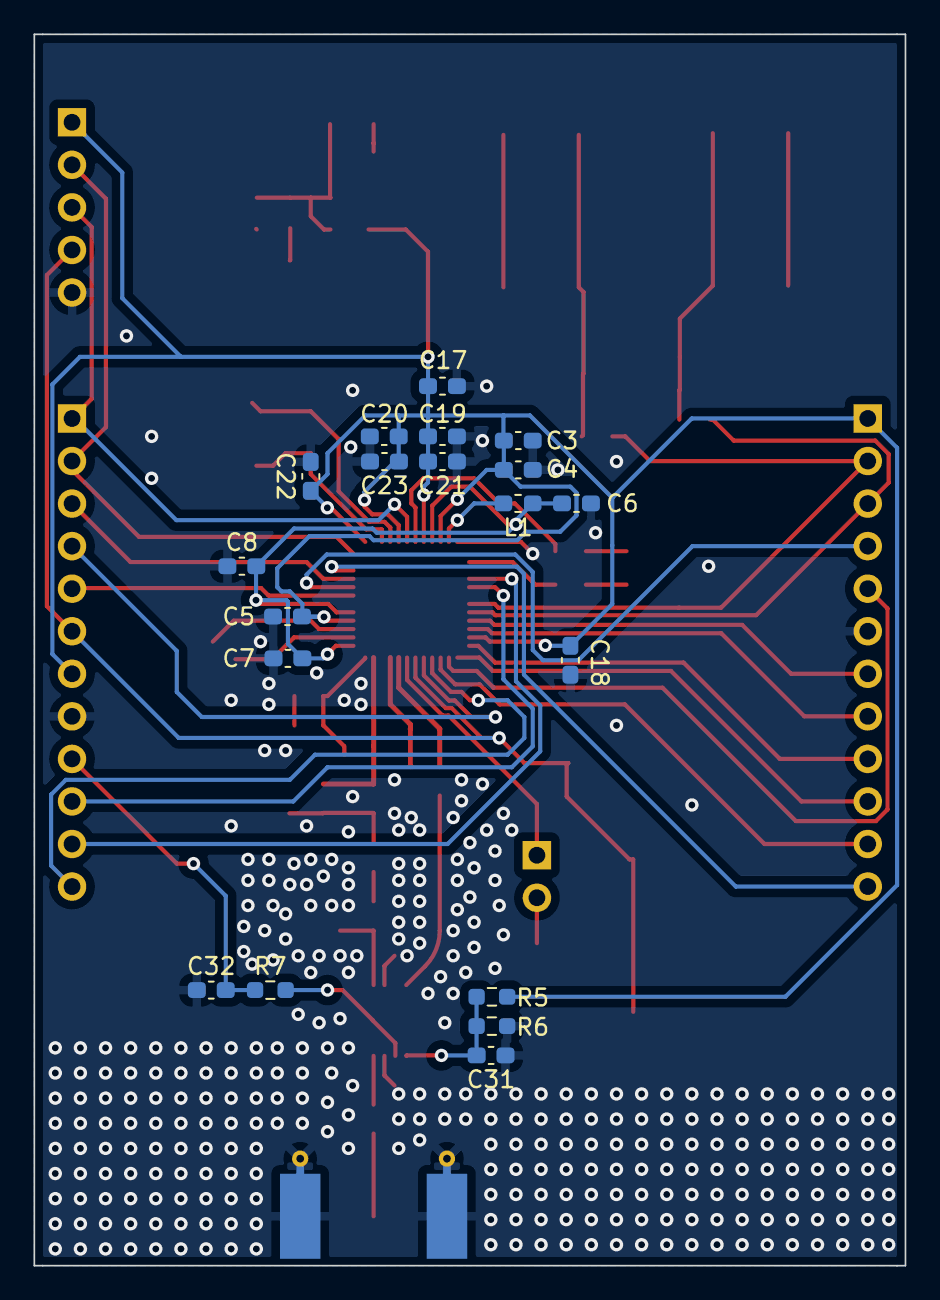
[picture p16: board MSK_RF.kicad_pcb from below]

Board: 2 copper layers, 52.0 x 73.5 mm, 65 parts (19 on the bottom side), 50 nets.
