piotrgrobelny/STM32WL-433MHZ-board/(commit log)

2022-04-15 Documentation and kicad schematics
    [MSK_RF.kicad_pcb, MSK_RF.kicad_sch]
2022-04-15 Second button
    [MSK_RF.kicad_sch]
2022-04-16 added connectors footprint
    [MSK_RF.kicad_sch]
2022-04-16 finished schematic with footprint
    [MSK_RF.csv, MSK_RF.kicad_pcb]
2022-04-19 Added i2c header
    [MSK_RF.kicad_sch]
2022-04-21 pcb update
    [MSK_RF.kicad_pcb, MSK_RF.kicad_sch]
2022-04-21 almost finished pcb
    [MSK_RF.kicad_pcb, MSK_RF.kicad_sch]
2022-04-25 finished pcb
    [MSK_RF.kicad_pcb, MSK_RF.kicad_sch]
2022-04-25 added pin description
    [MSK_RF.kicad_pcb]
2022-04-25 diode description
    [MSK_RF.kicad_pcb]
2022-04-25 drc inspection solved
    [MSK_RF.kicad_pcb]
2022-04-26 gerber files
    [MSK_RF-B_Silkscreen.gbr, MSK_RF-Dolna pasty.gbr, MSK_RF-Dolna sodermaski.gbr, MSK_RF-Dolna sygnałowa.gbr, MSK_RF-F_Silkscreen.gbr, MSK_RF-Górna pasty.gbr, MSK_RF-Górna soldermaski.gbr, MSK_RF-Górna sygnałowa.gbr]
2022-04-26 pin description
    [MSK_RF.kicad_pcb]
2022-04-28 vias update
    [MSK_RF-B_Silkscreen.gbr, MSK_RF-Dolna pasty.gbr, MSK_RF-Dolna sodermaski.gbr, MSK_RF-Dolna sygnałowa.gbr, MSK_RF-F_Silkscreen.gbr, MSK_RF-Górna pasty.gbr, MSK_RF-Górna soldermaski.gbr, MSK_RF-Górna sygnałowa.gbr]
2022-05-19 documentation and description
    [Elements.csv, MSK_RF.kicad_sch]
2022-05-19 pcb signal path
    [MSK_RF.kicad_pcb]
